TenteEEEE/IPD-Relativty/stl/Side_holder.stl

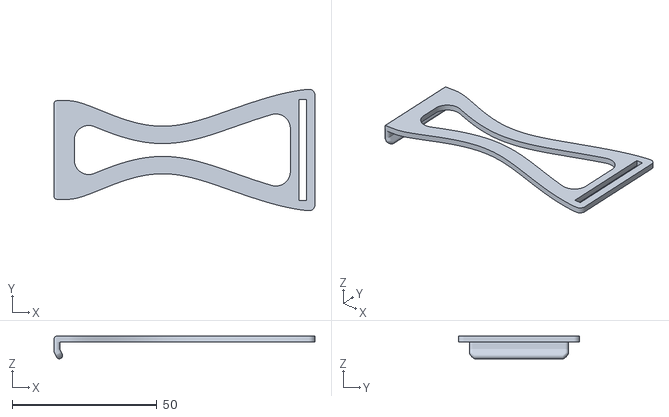
[picture p14: CAD file, 2020-10-27]
stl/Side_holder.stl
90.0 x 41.9 x 7.84
