TenteEEEE/IPD-Relativty/stl/FaceCover.stl

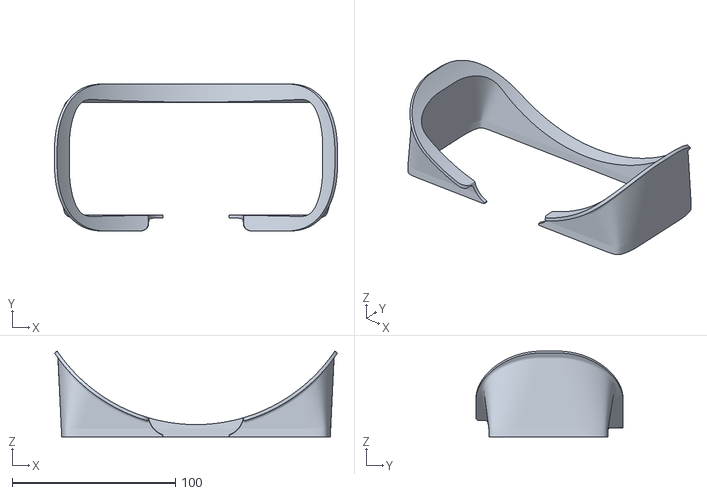
[picture p15: CAD file, 2020-10-27]
stl/FaceCover.stl
173.3 x 90.0 x 52.5
