TenteEEEE/IPD-Relativty/stl/Separator.stl

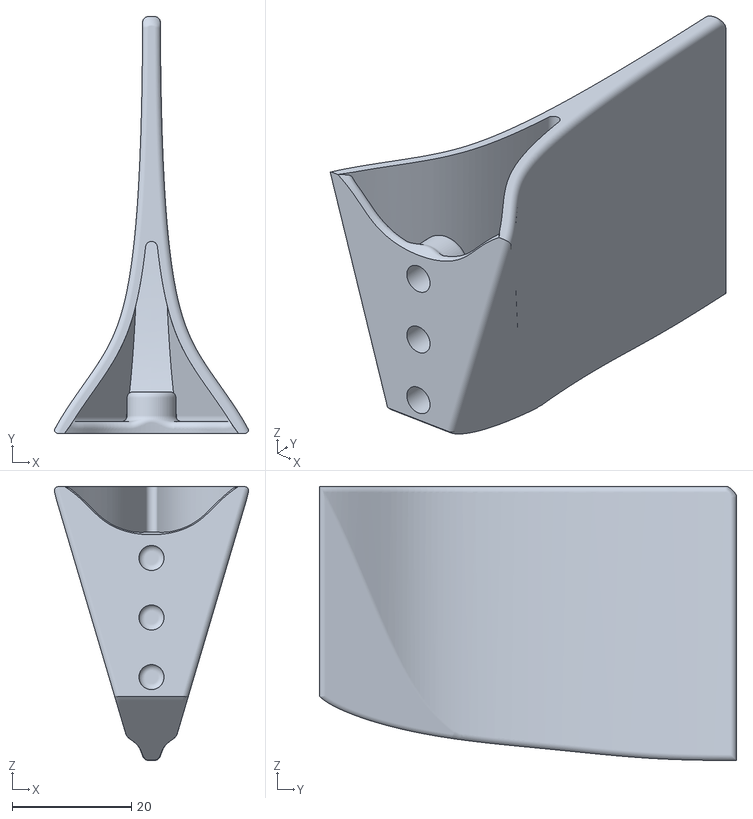
[picture p16: CAD file, 2020-10-27]
stl/Separator.stl
32.6 x 70.0 x 46.0
