TenteEEEE/IPD-Relativty/stl/Lens_mounter.stl

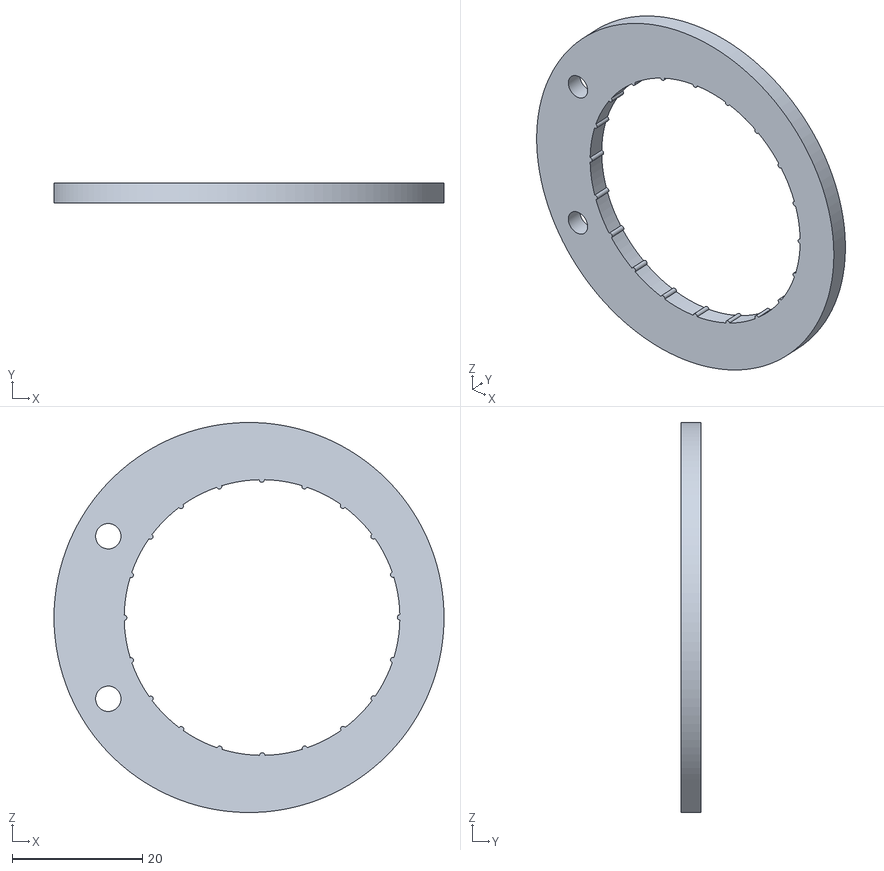
[picture p17: CAD file, 2020-10-27]
stl/Lens_mounter.stl
60.0 x 3.00 x 60.0
