TenteEEEE/IPD-Relativty/stl/R_display.stl

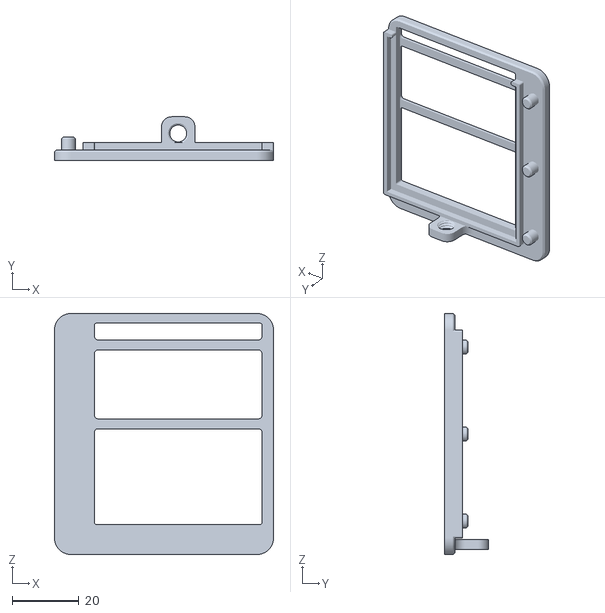
[picture p18: CAD file, 2020-10-27]
stl/R_display.stl
65.5 x 13.0 x 72.0
