TenteEEEE/IPD-Relativty/stl/Bottom.stl

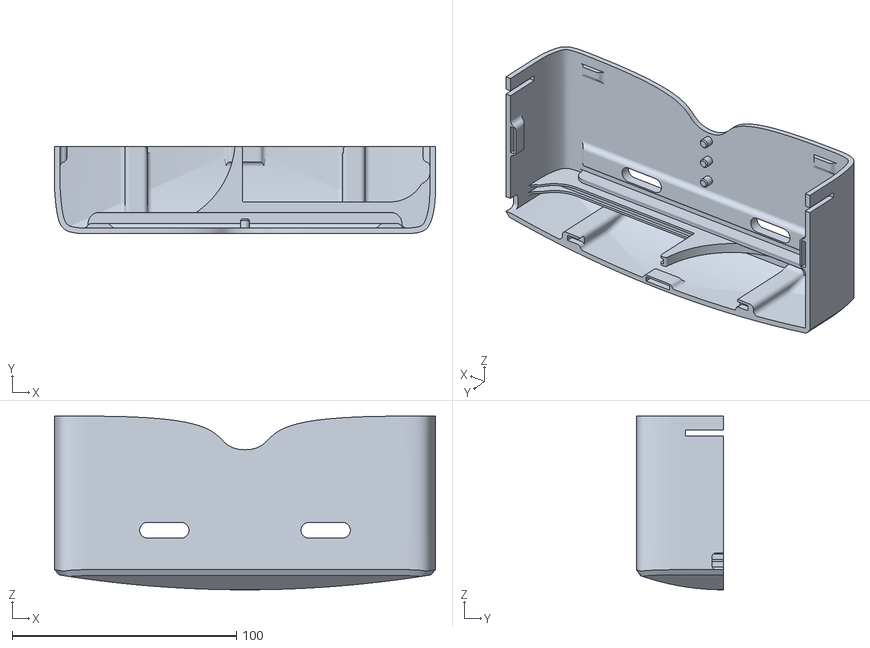
[picture p19: CAD file, 2020-10-27]
stl/Bottom.stl
170.0 x 39.0 x 77.5
