TenteEEEE/IPD-Relativty/stl/Eyebox_pillar.stl

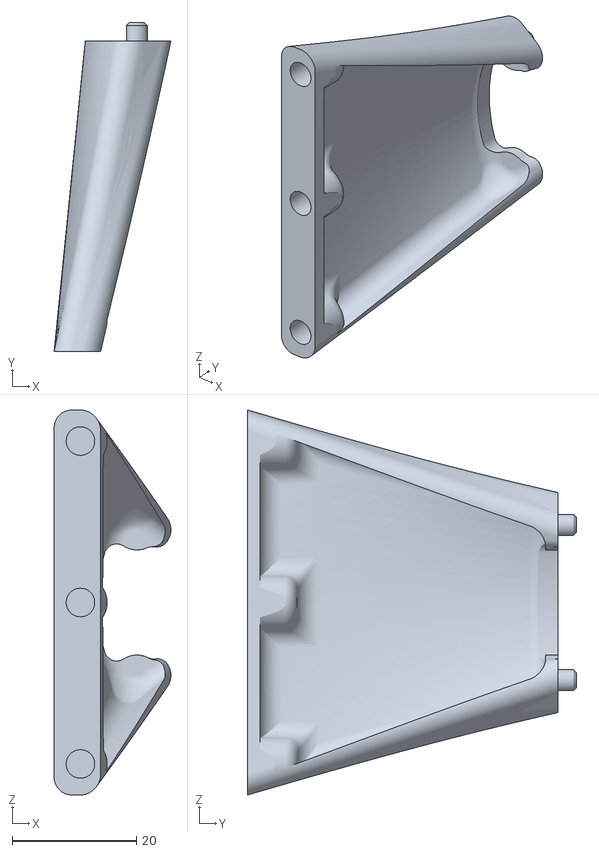
[picture p20: CAD file, 2020-10-27]
stl/Eyebox_pillar.stl
18.8 x 53.0 x 62.0
