TenteEEEE/IPD-Relativty/stl/Top_holder.stl

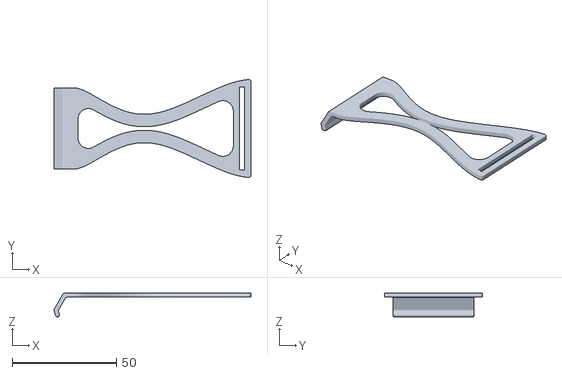
[picture p21: CAD file, 2020-10-27]
stl/Top_holder.stl
94.5 x 46.9 x 11.5
