TenteEEEE/IPD-Relativty/stl/Top.stl

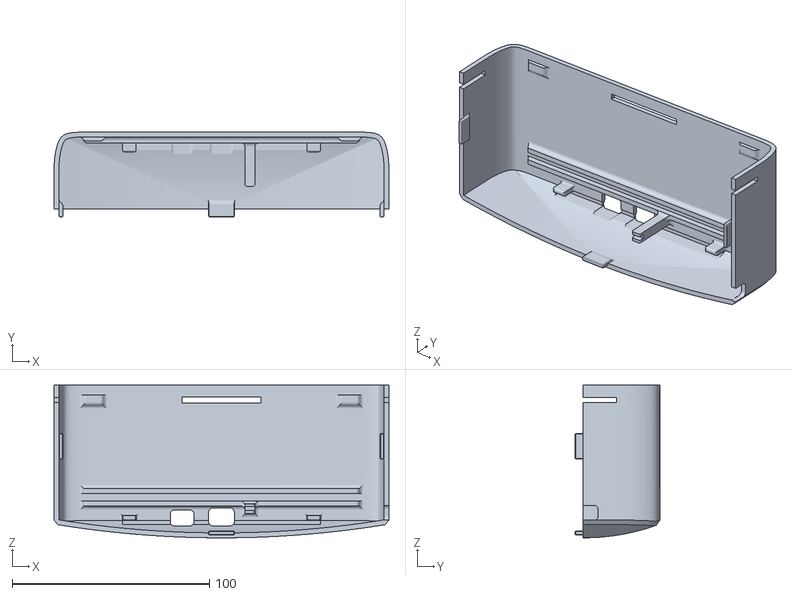
[picture p22: CAD file, 2020-10-27]
stl/Top.stl
170.0 x 43.0 x 77.5
