TenteEEEE/IPD-Relativty/stl/Screw.stl

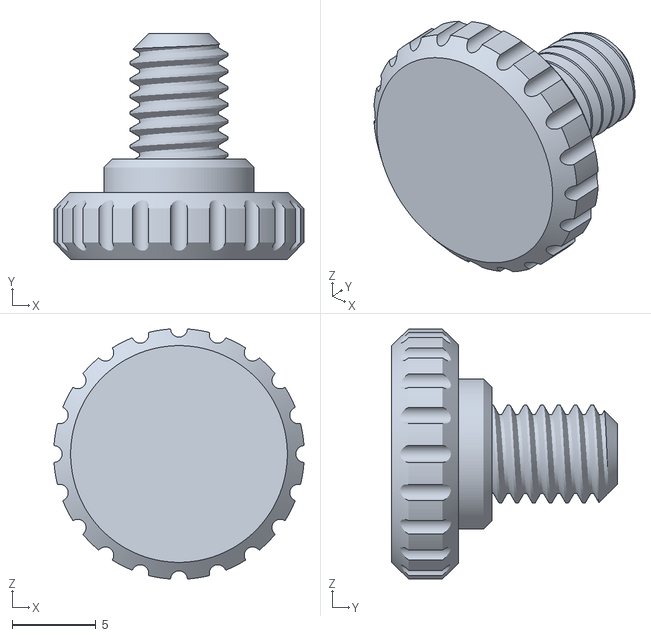
[picture p23: CAD file, 2020-10-27]
stl/Screw.stl
15.0 x 13.5 x 15.0
