TenteEEEE/IPD-Relativty/(list of files, cad)

Other CAD files:
stl/L_display.stl
